beauahill/Redlight-/docs/PLAN.md

# Build plan

Running notes on where the hardware build stands and what's decided.

## What we know (from teardown photos)

* Housing: original "Red Light 2.0_V4" (buzzproducts.com). The original brain
  was an Electric Imp IMP002 module, which no longer works because its cloud
  service was shut down.
* Tower: hexagonal column with **6 LED strips**, one per face. Each strip
  lands on a pad pair labelled D1–D6 around the center screw of the original
  board. The original board switched each strip low-side with its own SOT-23
  transistor. The strips themselves are **independent** rigid LED strips with
  "+" marked next to their pads at both ends; any shared connection was only
  on the old board.
* The original board is also the tower's mechanical mount (center screw +
  soldered strip tabs).
* Last winter's build added six TO-220 MOSFETs (IRF540N) on the + pads. An
  N-channel MOSFET on the high side from a 3.3 V gate only passes about 1 V,
  and the IRF540N isn't logic-level anyway. Remove them.
* Already in the housing: barrel jack (panel-mounted), slide switch, DROK
  mini buck converter, lithium protection board, XIAO ESP32-C6 with screw
  terminals.

## Decisions

* **Speaker:** original 4 Ω 3 W, driven by a MAX98357A (≈3 W into 4 Ω at
  5 V). At full volume it can pull ~0.8 A from 5 V, so size the UPS module
  for 2 A.
* **Board:** XIAO ESP32-C6 (XIAO C3 kept as a spare; PCB uses the XIAO footprint).
* **Power:** 3 salvaged 18650 Li-ion cells **in parallel (1S3P)** → 1S
  load-sharing charge/boost (UPS) module → 5 V rail. Barrel jack takes a
  plain 5 V 2 A adapter. The old 3S protection board and DROK buck are no
  longer needed. See WIRING.md → Power for module requirements and cell checks.
* **LED driver:** single TBD62083APG low-side driver (ULN2803A as fallback).
  All strip + pads on the 5 V rail, each strip's – switched.
* **Direction:** custom replacement PCB in the original board's outline that
  carries the tower and all electronics (pending measurements).

## Open questions

- [ ] Choose the UPS module (needs tower current to size it).
- [ ] Current per strip, and whether the strips have built-in resistors.
- [ ] Where the cells sit (3D-printed insert?) vs. electronics on the new PCB.
- [ ] Insert design file (STL/3MF/STEP).

## Board geometry (fit-test v2: `cad/fit_test.py` → `cad/out/fit_test.stl`)

* MEASURED: 109.5 mm circle with two parallel flats 74.15 mm apart, 4 mm
  center hole for the tower's plastic core screw. No top flat needed.
* Strip tabs pass through slots in the board: tabs 6 mm wide, ~6.7 mm from
  the screw center (MEASURED). Tab thickness and button positions are still
  estimates. D1–D6 on the plate is our numbering, counter-clockwise from +X.
* Each tab has a + and a – pad. The new board puts + on 5 V and routes – to
  the driver. No mounting holes; the board appears to slide into grooves in
  the housing.
* The barrel jack is a bare panel connector (5.5×2.1 mm); no charger yet.

## PCB v2 — `cad/pcb/` (see its README)

* Routed, DRC clean (0 unconnected, no copper errors), Gerbers in
  `cad/pcb/redlight-gerbers.zip`. Don't order until the open items below are done.
* Speaker is 11 mm below the board, so tall parts are on the tower side; the
  speaker side has only the TEST switch and wire pads.
* Tab slots 5.7 × 1.25 mm for the 5.15 mm tabs (extra length covers the
  fab's ~0.5 mm router corner radius), centered at r = 7.3 mm
  (strip inside faces 13.6 mm across, MEASURED); screw hole 4.2 mm.
* TEST / VOL+ / VOL- at the measured positions, on one ADC pin (resistor ladder).
* No support tab: tried one into the housing recess, it didn't fit as hoped.
* Red glass necks to ~82 mm ID 13 mm above the board: tower-side parts kept
  ≤ 9.5 mm (XIAO on low-profile headers, amp module soldered flat without its
  terminal block, 6.3 × 7 mm cap). Checked by `fit_stl.py`.
* Strips: 10 red LEDs in parallel behind an on-strip 20 Ω resistor ("200"),
  so R1–R6 are 0 Ω jumpers. MEASURED: 3.0 V across the resistor at 5 V, so
  150 mA per strip (≈ 135 mA through the driver). Strobe (all six) ≈ 0.8 A,
  peak with audio ≈ 1.5 A: within the 2.5 A module and 500 mA/channel.
  * The on-strip resistor dissipates ~0.36 W while lit; patterns are duty
    cycled. Firmware "Light brightness" defaults to 80 % for extra margin.
* Board is ready to order (the strip current only affects firmware tuning).

## Battery insert — `cad/insert/`

* `RedLight_Insert_rev04.step`: the user's SolidWorks insert (reference, unchanged).
  Its battery tube is sized for two 2-cell 18650 holders side by side, so the
  door screws on with no play.
* `insert.py` → `out/RedLight_Insert_rev07.*`: rev04 cleaned up. Kept exactly:
  flange, door recess + screw boss, collar, ears and half-round bumps, the
  battery tube (no lip, identical to rev04 inside), side bay walls, the on/off
  switch hole and its wire channel. Removed: the old BMS/ESP holders. Added:
  slotted rails + stop in the side bay for the DFR0446 module.
* Cells: 4 × 18650 in the user's two 2-cell holders (the 3-cell sled is retired).
  Currently wired in series (2S2P). Open decision: keep 2S2P (8.4 V charger,
  balancing 2S BMS, buck to 5 V, R7/R8 = 300k/100k) or rewire as 1S4P
  (DFR0446 charge/boost module, plain 5 V adapter, board unchanged).

## Measurements needed for the PCB

1. Outline: straight-down photo on paper with a ruler, plus overall width,
   height and the flat edges.
2. Center screw hole: diameter and position from two edges.
3. Tower pads: radius from center to each pair, pad size, gap within a pair,
   tower base width across flats.
4. Mounting holes to the housing: positions and diameters.
5. Board thickness (likely 1.6 mm).
6. Height clearance above and below the board inside the housing.
7. Position of the button cap, speaker and wire routes relative to the board.

## Firmware to-do

- [x] Battery voltage sense on XIAO C6 D2 (light 3 moved to D6), shown on the
      web page with a low-battery warning.
- [ ] Optional quiet hours / sleep to stretch battery life.
- [ ] Verify the XIAO C3 pin map against its strapping pins before the PCB is final.
