beauahill/Redlight-/cad/insert/out/battery_sled_preview.png

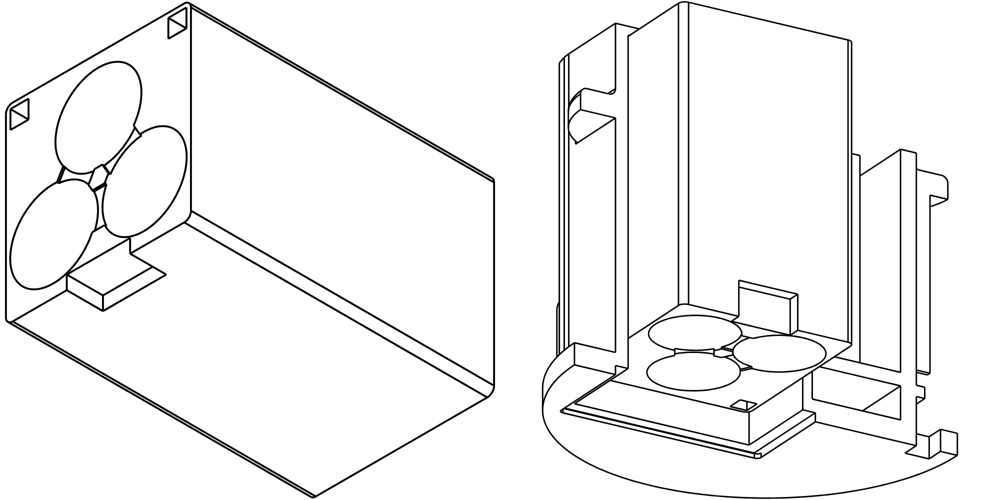
cad/insert/out/battery_sled_preview.png
