beauahill/Redlight-/cad/insert/out/insert_cleanup_questions.png

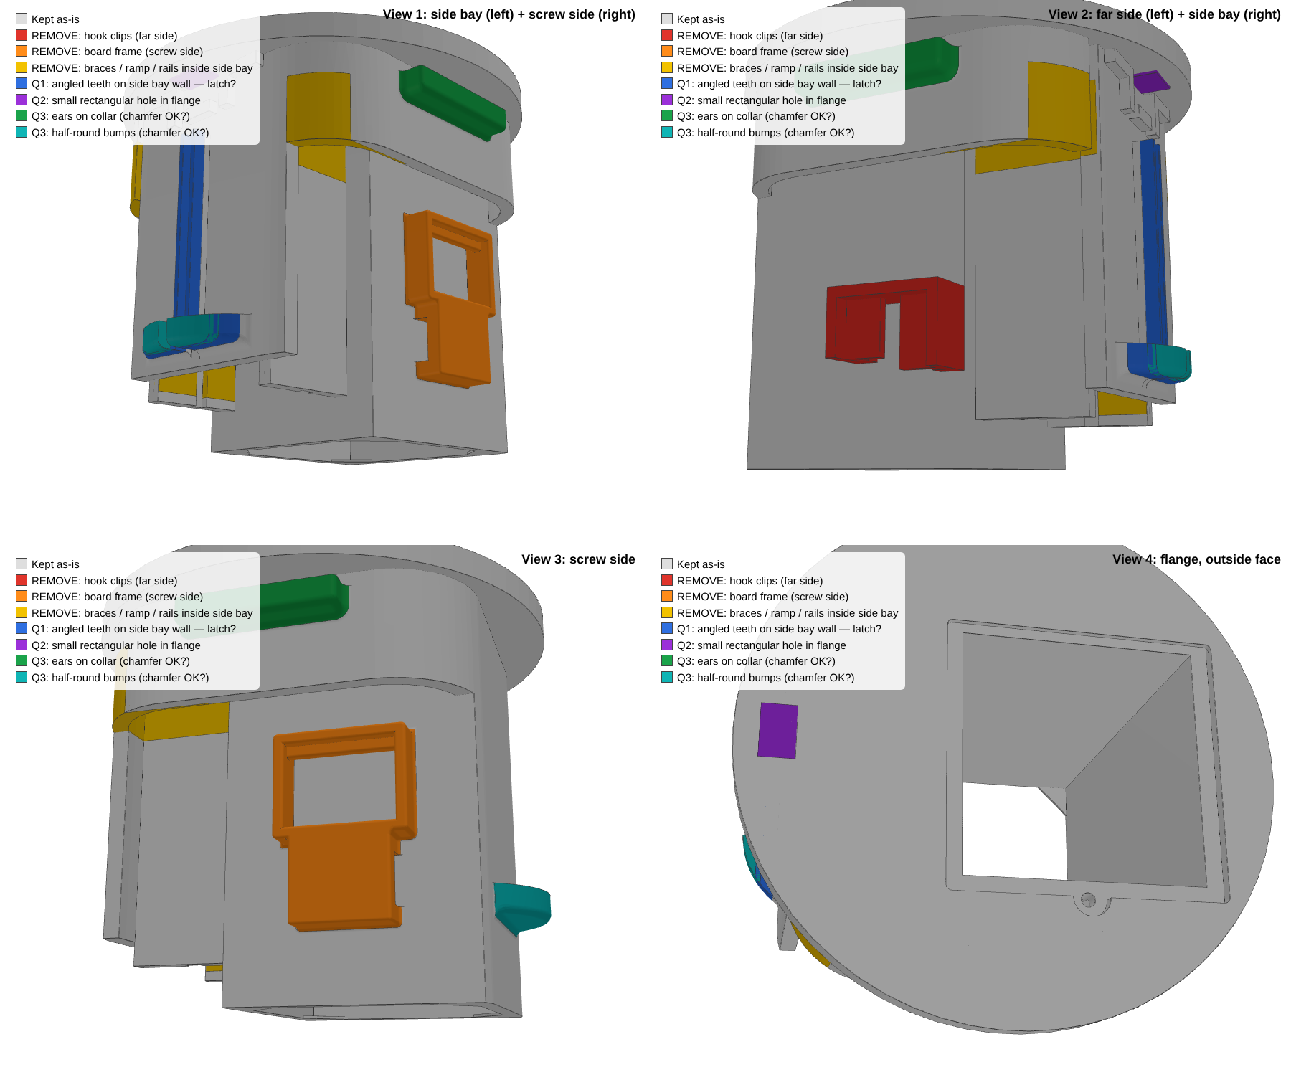
cad/insert/out/insert_cleanup_questions.png
