beauahill/Redlight-/cad/insert/out/insert_rev06_preview.png

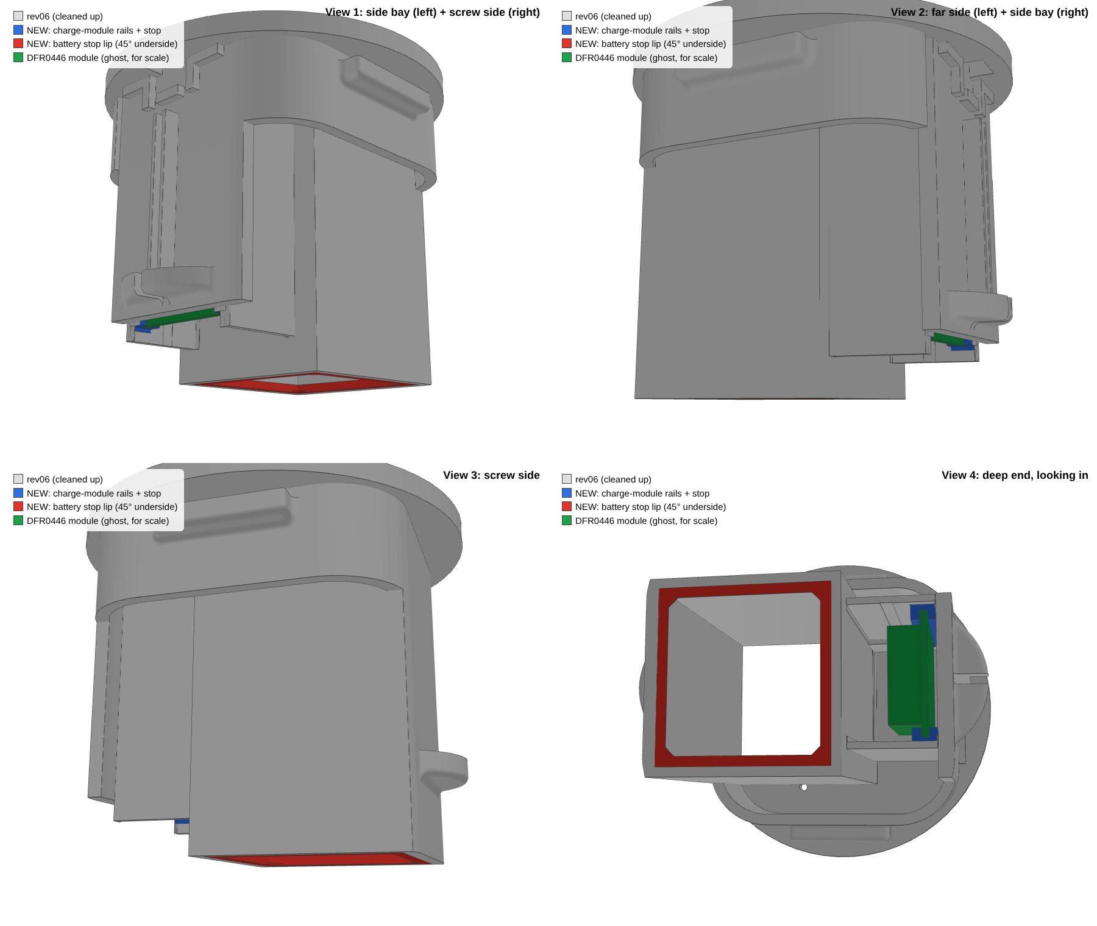
cad/insert/out/insert_rev06_preview.png
