beauahill/Redlight-/cad/pcb/out/redlight_fit_preview.png

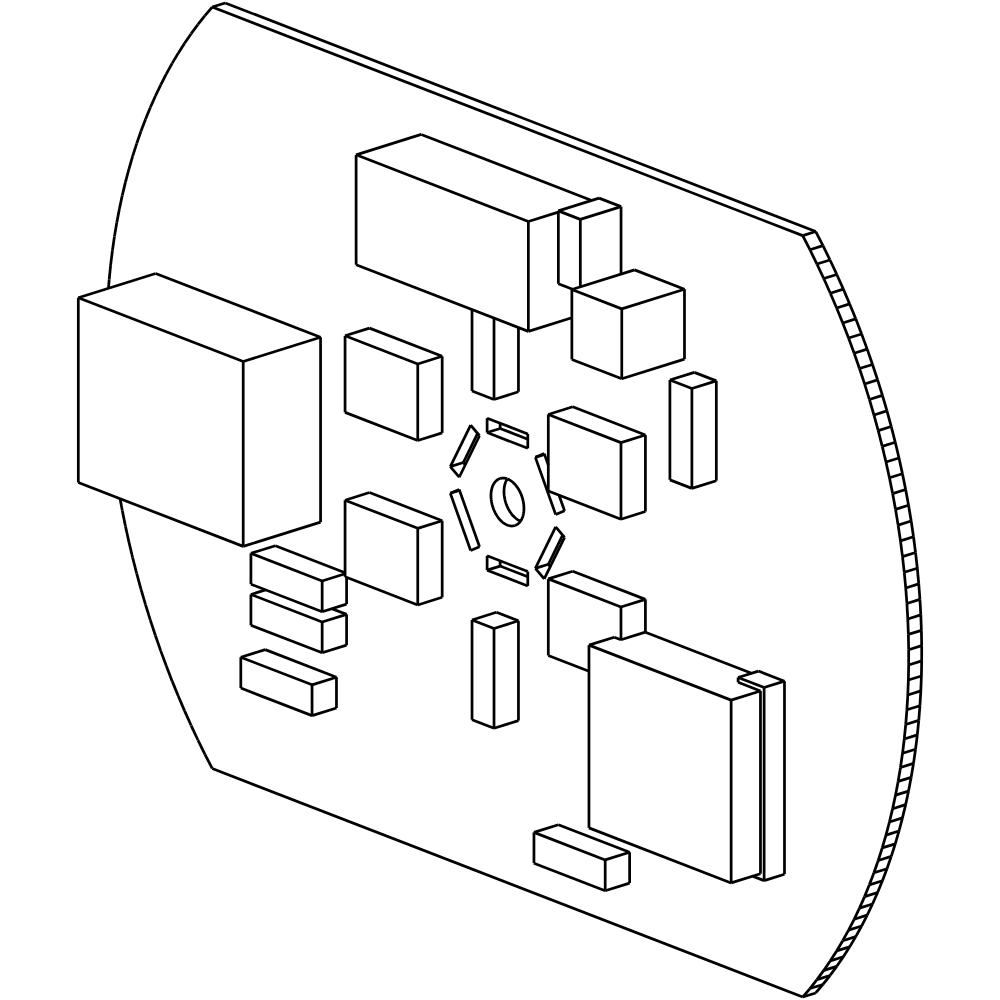
cad/pcb/out/redlight_fit_preview.png
