beauahill/Redlight-/cad/pcb/out/tower_pads.png

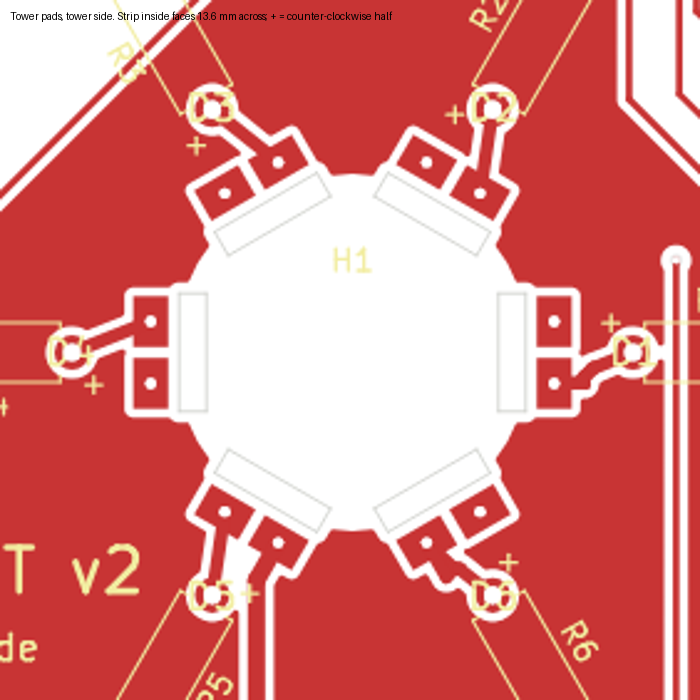
cad/pcb/out/tower_pads.png
