beauahill/Redlight-/cad/insert/out/RedLight_Insert_rev07.step

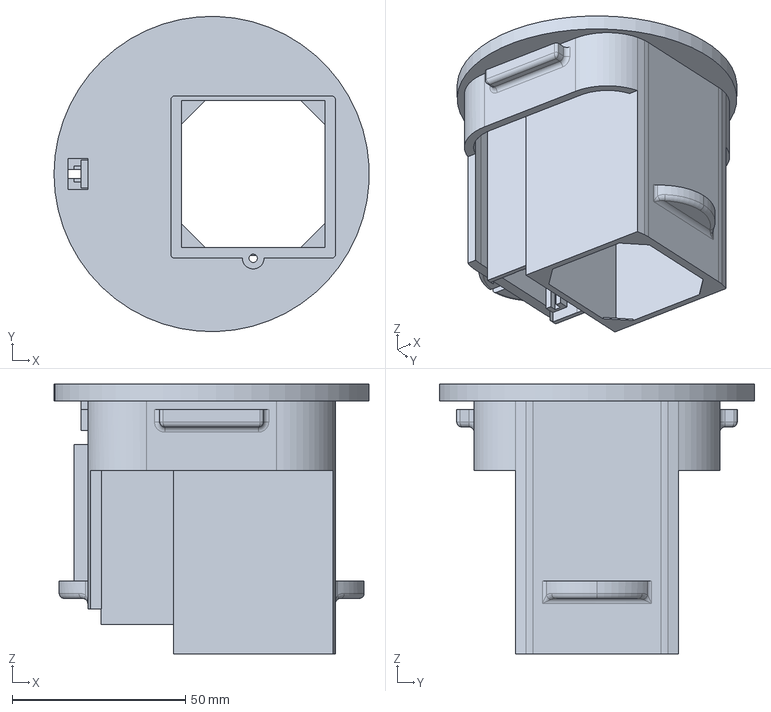
[picture p8: CAD file, 2026-11-05]
cad/insert/out/RedLight_Insert_rev07.step
90.9 x 91.0 x 77.9 mm
