beauahill/Redlight-/cad/insert/RedLight_Insert_rev04.step

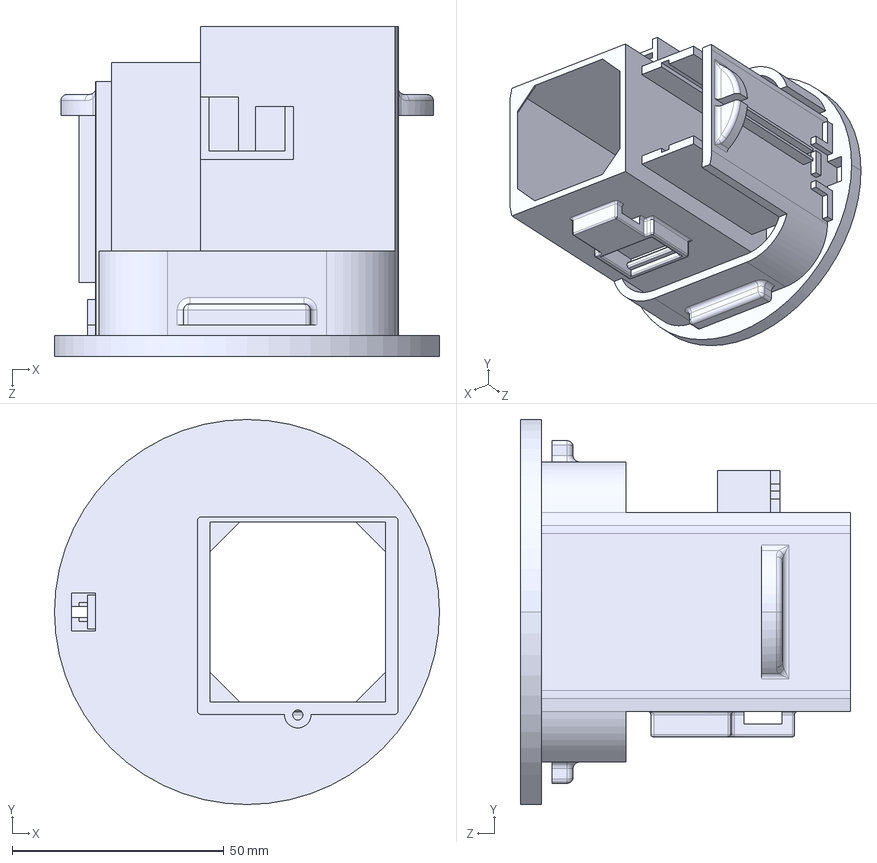
[picture p9: CAD file, 2026-11-01]
cad/insert/RedLight_Insert_rev04.step
91.0 x 91.0 x 77.9 mm
