beauahill/Redlight-/cad/out/fit_test.step

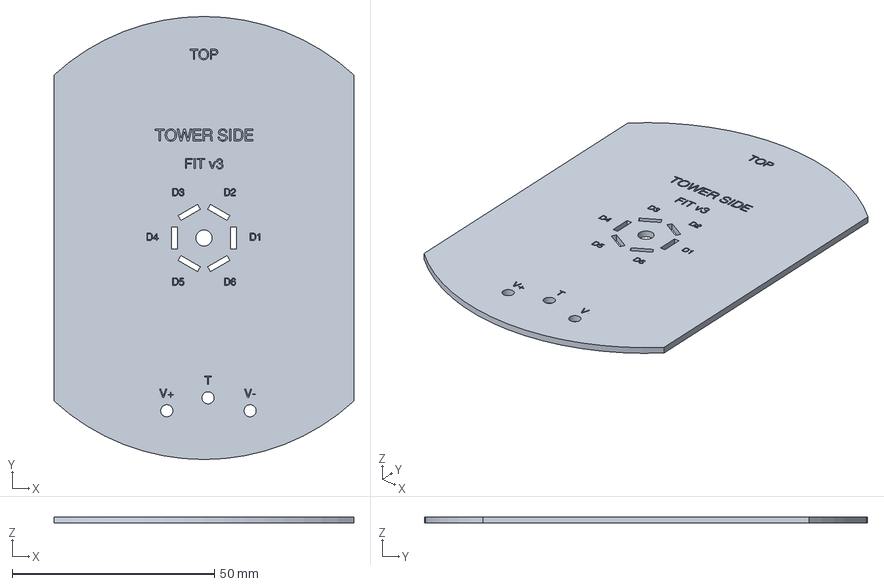
[picture p10: CAD file, 2026-11-02]
cad/out/fit_test.step
74.2 x 109.5 x 1.60 mm
