beauahill/Redlight-/cad/pcb/out/redlight_fit.step

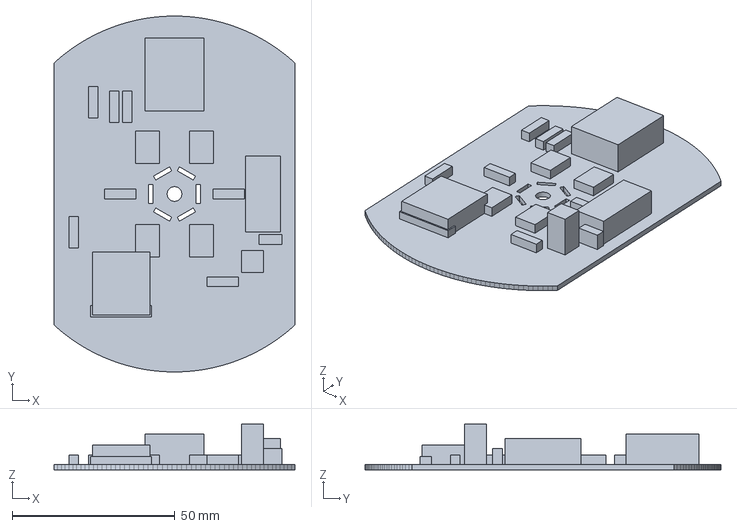
[picture p11: CAD file, 2026-11-02]
cad/pcb/out/redlight_fit.step
74.2 x 109.5 x 14.1 mm
