beauahill/Redlight-/cad/pcb/out/slot_coupon.stl

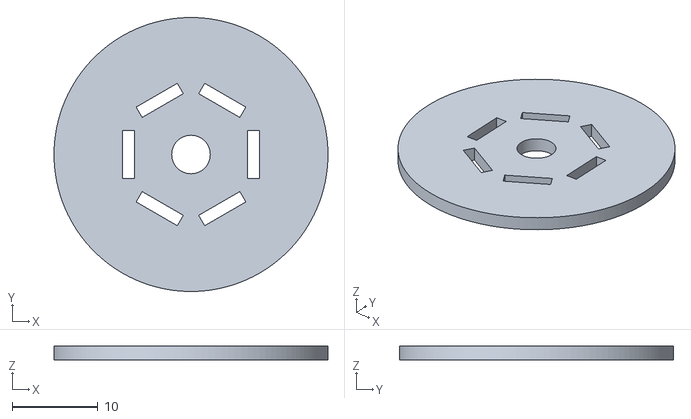
[picture p12: CAD file, 2026-11-02]
cad/pcb/out/slot_coupon.stl
32.0 x 32.0 x 1.60
