beauahill/Redlight-/(list of files, cad)

Other CAD files:
cad/insert/out/RedLight_Insert_rev07.stl
cad/out/fit_test.stl
cad/pcb/out/redlight_fit.stl
