beauahill/Redlight-/cad/fit_test_preview.png

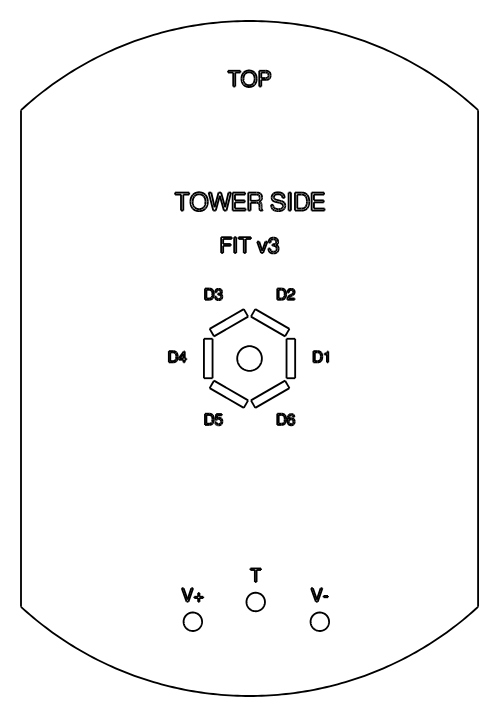
cad/fit_test_preview.png
