beauahill/Redlight-/cad/pcb/redlight.kicad_pcb

## KiCad design cad/pcb/redlight.kicad_pcb (2026-11-02)

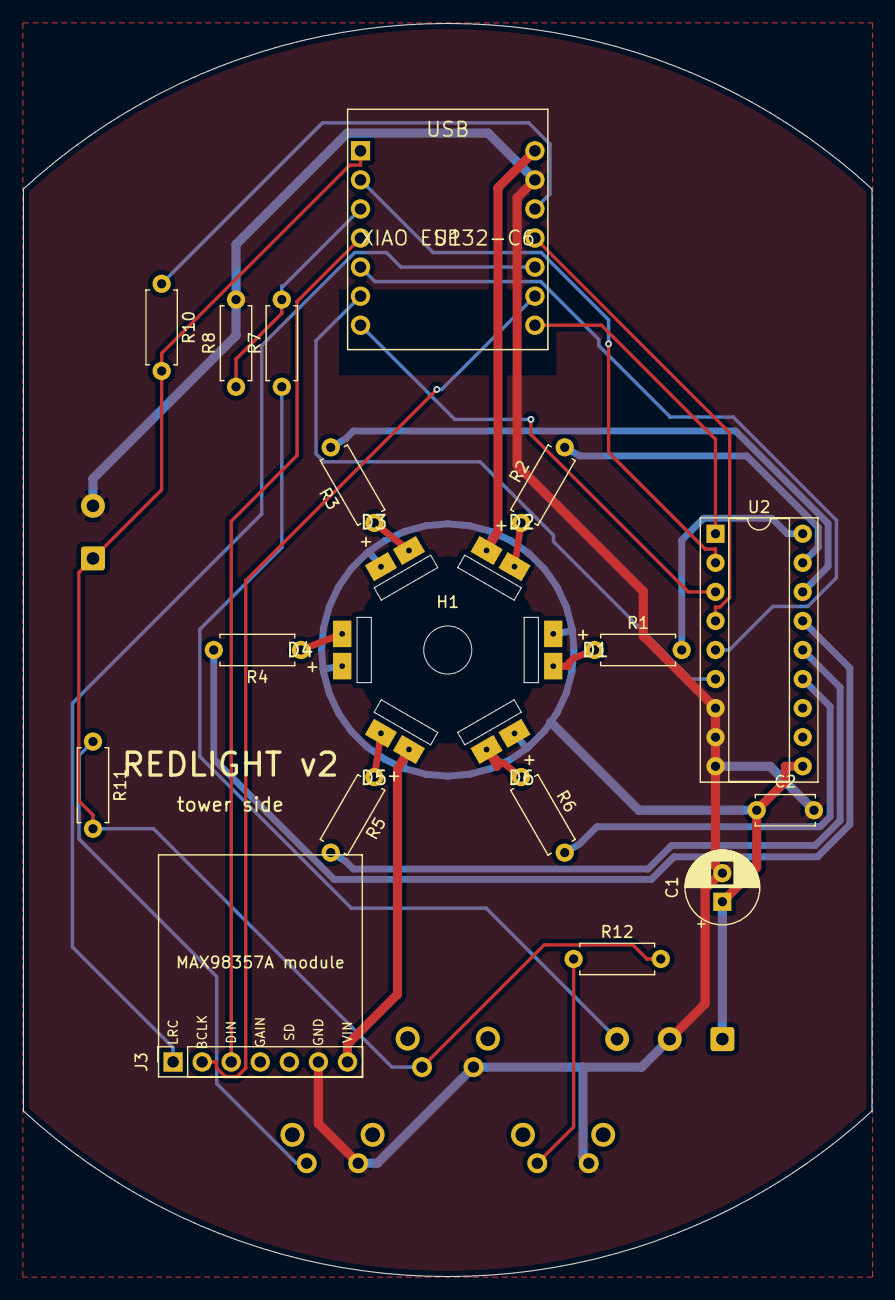
[picture p14: board redlight.kicad_pcb from above]

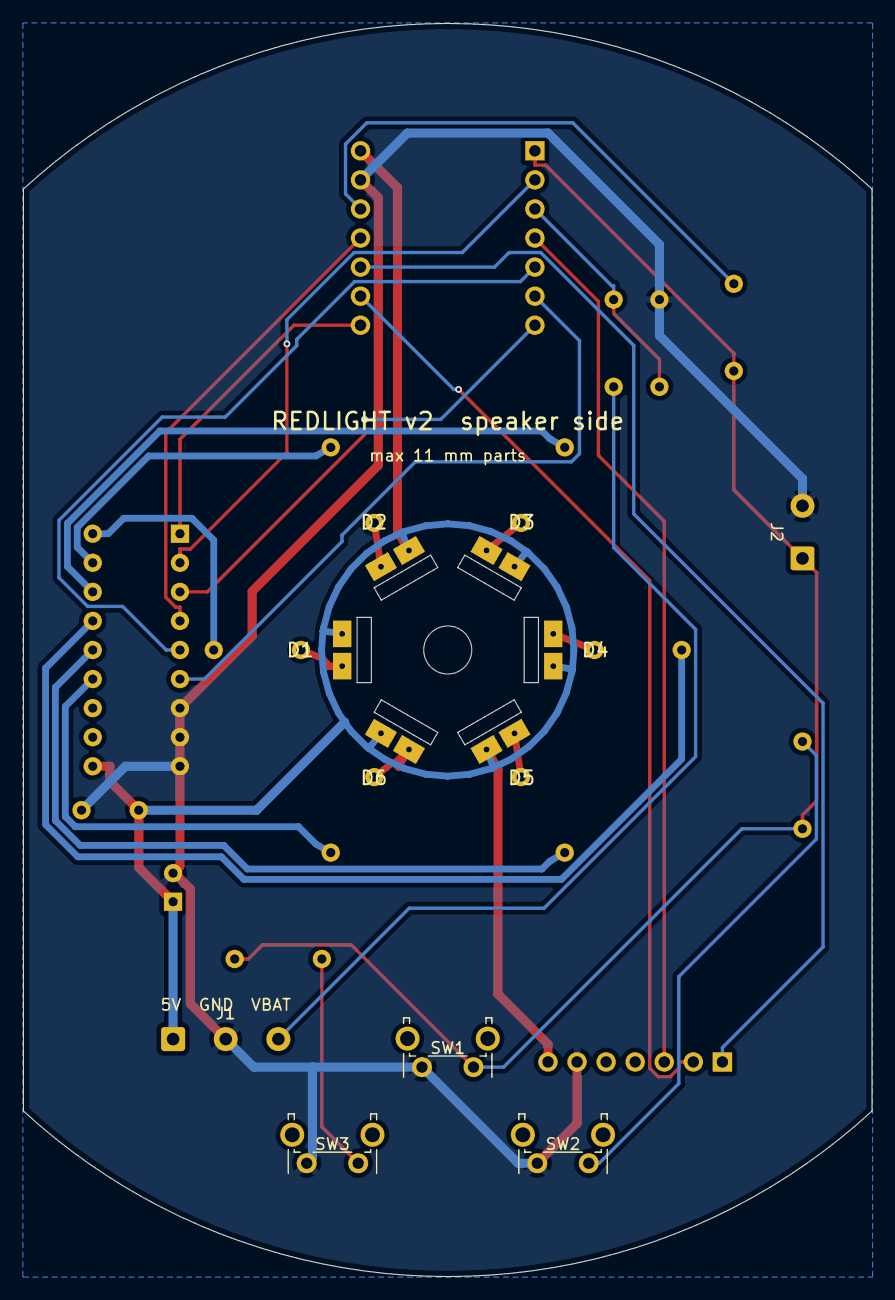
[picture p15: board redlight.kicad_pcb from below]

Board: 2 copper layers, 74.1 x 109.5 mm, 28 parts (5 on the bottom side), 29 nets.

Parts:
C1: 220uF 10V 6.3x7; CP_Radial_D6.3mm_P2.50mm
C2: 100nF; C_Disc_D5.0mm_W2.5mm_P5.00mm
H1: tower screw; MountingHole_3.2mm_M3
J1: 5V GND VBAT; SolderWire-0.5sqmm_1x03_P4.6mm_D0.9mm_OD2.1mm
J2: EXT TEST; SolderWire-0.5sqmm_1x02_P4.6mm_D0.9mm_OD2.1mm
J3: MAX98357A; PinSocket_1x07_P2.54mm_Vertical
LED1, LED2, LED3, LED4, LED5, LED6: strip tab
R1, R2, R3, R4, R5, R6: 0R; R_Axial_DIN0207_L6.3mm_D2.5mm_P7.62mm_Horizontal
R7, R8: 100k; R_Axial_DIN0207_L6.3mm_D2.5mm_P7.62mm_Horizontal
R10: 10k; R_Axial_DIN0207_L6.3mm_D2.5mm_P7.62mm_Horizontal
R11: 2k2; R_Axial_DIN0207_L6.3mm_D2.5mm_P7.62mm_Horizontal
R12: 6k8; R_Axial_DIN0207_L6.3mm_D2.5mm_P7.62mm_Horizontal
SW1: TEST; SW_Tactile_SPST_Angled_PTS645Vx31-2LFS
SW2: VOL+; SW_Tactile_SPST_Angled_PTS645Vx31-2LFS
SW3: VOL-; SW_Tactile_SPST_Angled_PTS645Vx31-2LFS
U1: XIAO ESP32-C6
U2: TBD62083APG; DIP-18_W7.62mm_Socket

Connections:
+3V3: R10.1, U1.3V3
+5V: C1.1, C2.1, J1.1, J3.7, LED1.+, LED2.+, LED3.+, LED4.+, LED5.+, LED6.+, U1.5V, U2.10
/BUTTONS: J2.1, R10.2, R11.2, R12.2, SW1.1, U1.D0
/I2S_BCLK: J3.2, U1.D8
/I2S_DIN: J3.3, U1.D3
/I2S_LRC: J3.1, U1.D9
/LIGHT1: U1.D7, U2.1
/LIGHT2: U1.D1, U2.2
/LIGHT3: U1.D6, U2.3
/LIGHT4: U1.D10, U2.4
/LIGHT5: U1.D4, U2.5
/LIGHT6: U1.D5, U2.6
/OUT1: R1.2, U2.18
/OUT2: R2.2, U2.17
/OUT3: R3.2, U2.16
/OUT4: R4.2, U2.15
/OUT5: R5.2, U2.14
/OUT6: R6.2, U2.13
/STRIP1-: LED1.-, R1.1
/STRIP2-: LED2.-, R2.1
/STRIP3-: LED3.-, R3.1
/STRIP4-: LED4.-, R4.1
/STRIP5-: LED5.-, R5.1
/STRIP6-: LED6.-, R6.1
/VBAT: J1.3, R7.1
/VOL+: R11.1, SW2.1
/VOL-: R12.1, SW3.1
/VSENSE: R7.2, R8.1, U1.D2
GND: C1.2, C2.2, J1.2, J2.2, J3.6, R8.2, SW1.2, SW2.2, SW3.2, U1.GND, U2.7, U2.8, U2.9
