beauahill/Redlight-/(commit log)

2026-10-30 Add ESP32-C3/C6 goal light firmware
    Drives a repurposed light-tower housing: switches the tower through a
    MOSFET and plays a horn WAV (or synthesized siren) through a MAX98357A
    when a favorite NHL team scores. WiFiManager setup, web settings page
    with TV delay, volume, WAV upload, and wiring docs for 5V wired power.
    Claude-Session: https://claude.ai/code/session_014zeCf4S4BcArxNfoY6CxYX
    [partitions.csv]
2026-10-30 Drive tower as individual lights in sequence
    The tower is a ring of separate lights rather than a motorized beacon.
    Drive each from its own GPIO (via ULN2803A) and animate them in a
    dedicated task: spin with fading tail, chase, strobe, alternate, with
    adjustable RPM. Wiring docs updated with tower measurement checklist.
    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
2026-10-30 Add parametric fit-test plate for the replacement tower PCB
    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
    [fit_test.step, fit_test.stl]
2026-10-30 Fit-test v2: plain circle with two flats
    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
    [fit_test.step, fit_test.stl]
2026-10-30 Switch to 1S3P 18650 power with battery gauge
    Salvaged 18650s in parallel behind a load-sharing 5V charge/boost
    module replace the 3S pack, protection board and buck. Add battery
    voltage sensing on XIAO C6 D2 (light 3 moves to D6) with percent and a
    low-battery warning on the web page.
    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
    [battery.cpp, config.h, main.cpp, web.cpp]
2026-10-30 Switch LED driver to TBD62783A for the shared-negative tower
    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
2026-10-30 Fit-test v3: real strip tab slots; note 4 ohm 3 W speaker
    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
    [fit_test.step, fit_test.stl]
2026-10-31 Use low-side TBD62083A driver now that strips are independent
    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
2026-10-31 Add replacement tower PCB: placement, routing script, fit model
    make_pcb.py builds the KiCad board (outline, tab slots, all parts on the
    bottom side), route.py autoroutes/pours/exports Gerbers via Freerouting,
    fit_stl.py makes a printable clearance model from the placed footprints.
    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
    [redlight.kicad_pcb, redlight_fit.step, redlight_fit.stl]
2026-10-31 Route the tower PCB and export Gerbers
    Freerouting via xvfb, SES imported by our own parser (KiCad 7's importer
    is GUI-only), ground pours on both layers with a keepout under the XIAO
    antenna, tab pads moved 0.5 mm off the slots for edge clearance. DRC:
    no copper errors or unconnected pads, only cosmetic silkscreen overlaps.
    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
    [redlight.kicad_pcb, redlight_fit.step]
2026-10-31 PCB v2: tall parts on tower side, support tab, tighter slots
    The speaker sits 11 mm under the board, so the XIAO, driver, amp module
    and capacitors move to the (hidden) tower side; the speaker side keeps
    only the angled TEST switch and wire solder pads. Add a 17.5 mm support
    tab concentric at r+4.3 mm into the housing recess with an optional power
    LED, tighten tab slots for the measured 5.15 mm tabs, open the screw hole
    to 4.2 mm. Tab pads are now single plated pads, a rule area keeps traces
    out from under the tower, and route.py retries until DRC is clean.
    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
    [redlight.kicad_pcb, redlight_fit.step, redlight_fit.stl]
2026-10-31 Add VOL+/VOL- buttons, measured button positions, 5V ring
    Place TEST, VOL+ and VOL- angled switches at the measured positions of
    the housing's buttons and read all three on one ADC pin through a resistor
    ladder (light 1 moves from D0 to D7 on the XIAO C6). Firmware: debounced
    ladder decoding, volume +/-10 with a confirmation beep.
    PCB: + is the clockwise half of each tab. Pre-route a 5V ring and the
    strip-to-resistor traces around the tower, and split tracks at the
    T-junctions Freerouting creates so KiCad sees them as connected (the cause
    of the intermittent unconnected-pad failures).
    Claude-Session: https://claude.ai/code/session_014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
    [redlight.kicad_pcb, redlight_fit.step, redlight_fit.stl]
2026-11-01 Add user's battery insert STEP and a 3x18650 sled for its main tube
    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
    [RedLight_Insert_rev04.step, battery_sled.step, battery_sled.stl]
2026-11-01 Battery sled for full-length cells, insert rev05 with a stop lip
    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
    [RedLight_Insert_rev05.step, RedLight_Insert_rev05.stl, battery_sled.step, battery_sled.stl]
2026-11-02 Center the support tab; keep the screw hole open in the fit model
    The fit model turned the tower screw hole's footprint courtyard into a
    solid block over the hole. Skip hole/tab footprints when building blocks.
    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
    [redlight.kicad_pcb, redlight_fit.step, redlight_fit.stl]
2026-11-02 Keep tower-side parts under the red glass neck; bare support tab
    The glass necks to ~82 mm ID 13 mm above the board. Remove the tab LED
    (only the board fits the recess), drop the XIAO to low-profile headers,
    solder the amp module flat without its terminal block, use a 6.3 x 7 mm
    cap, and have fit_stl.py fail if a part outside r=41 mm is taller than
    12 mm.
    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
    [redlight.kicad_pcb, redlight_fit.step, redlight_fit.stl]
2026-11-02 Swap tab +/- pads: + is the counter-clockwise half
    Checked against the real strips on the fit print; the earlier reading of
    "left pad" was mirrored.
    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
    [redlight.kicad_pcb, redlight_fit.step]
2026-11-02 Add color-coded insert cleanup render
    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
2026-11-02 Insert rev06: cleaned-up rev04 with module rails and stop lip
    Remove the old BMS/ESP holders (hook clips, board frame, side-bay braces,
    ramp, rails and floor) while keeping every fit feature and the walls that
    carry the collar. Add a 45-degree battery stop lip and slotted rails for
    the DFR0446 charge module in the side bay. Route the flange slide switch
    between the module output and the PCB.
    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
    [RedLight_Insert_rev05.step, RedLight_Insert_rev05.stl, RedLight_Insert_rev06.step, RedLight_Insert_rev06.stl, battery_sled.step]
2026-11-02 LED strips have on-board 20 ohm resistors: R1-R6 become jumpers
    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
    [redlight.kicad_pcb, redlight_fit.step]
2026-11-02 Remove the PCB support tab
    It didn't fit the housing recess the way it was meant to; the board is
    back to the plain 109.5 mm circle with two flats.
    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
    [redlight.kicad_pcb, redlight_fit.step, redlight_fit.stl]
2026-11-02 Record strip measurement: ~20 mA at 5 V, board ready to order
    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
2026-11-02 Correct strip measurement notes: reading included the old board
    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
2026-11-02 Add light brightness setting, default 80%
    Measured 3.0 V across each strip's 20 ohm resistor at 5 V (150 mA). The
    setting scales PWM duty to keep those resistors cooler; adjustable 10-100%
    from the web page.
    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
2026-11-02 Label MAX98357A pins at J3; record final pre-order check
    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
    [redlight.kicad_pcb, redlight_fit.step]
2026-11-02 Move strip slots out: inside faces 13.6 mm across
    Slot centers move from r = 6.7 to 7.3 mm (strip inside faces measured at
    13.6 mm apart + half the 1.0 mm tab). The tab pads, 5V ring, LED resistor
    pads and the under-tower keepout are now derived from the slot radius.
    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
    [fit_test.step, fit_test.stl, redlight.kicad_pcb, redlight_fit.step, redlight_fit.stl]
2026-11-02 Add a small slot-coupon STL to check the strip spacing
    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
    [slot_coupon.stl]
2026-11-02 Lengthen strip slots to 5.7 mm for the fab's router corner radius
    A ~1 mm bit rounds the slot ends; at 5.4 mm the usable length at the
    tab's square corners would be ~5.06 mm, less than the 5.15 mm tab.
    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
    [redlight.kicad_pcb]
2026-11-02 C1 can be a standard 6.3 x 11 mm cap; add part numbers for C1/C2
    C1 sits inside the glass neck, so the 12 mm height limit doesn't apply;
    the fit model's glass check passes with 12.5 mm.
    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
    [redlight_fit.step, redlight_fit.stl]
2026-11-05 Insert rev07: drop the stop lip, retire the 3-cell sled
    The user's battery tube is sized for two 2-cell 18650 holders with the door
    screwed on and no play; the lip would have stolen 2.5 mm. rev07 keeps the
    tube identical to rev04.
    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
    [RedLight_Insert_rev06.step, RedLight_Insert_rev06.stl, RedLight_Insert_rev07.step, RedLight_Insert_rev07.stl, battery_sled.step, battery_sled.stl]
